UWCubeSat/HS1_Motor_Test/MSP430 Breakout_V2/MSP430 Breakout.kicad_pcb

## KiCad design MSP430 Breakout_V2/MSP430 Breakout.kicad_pcb (2022-03-03)

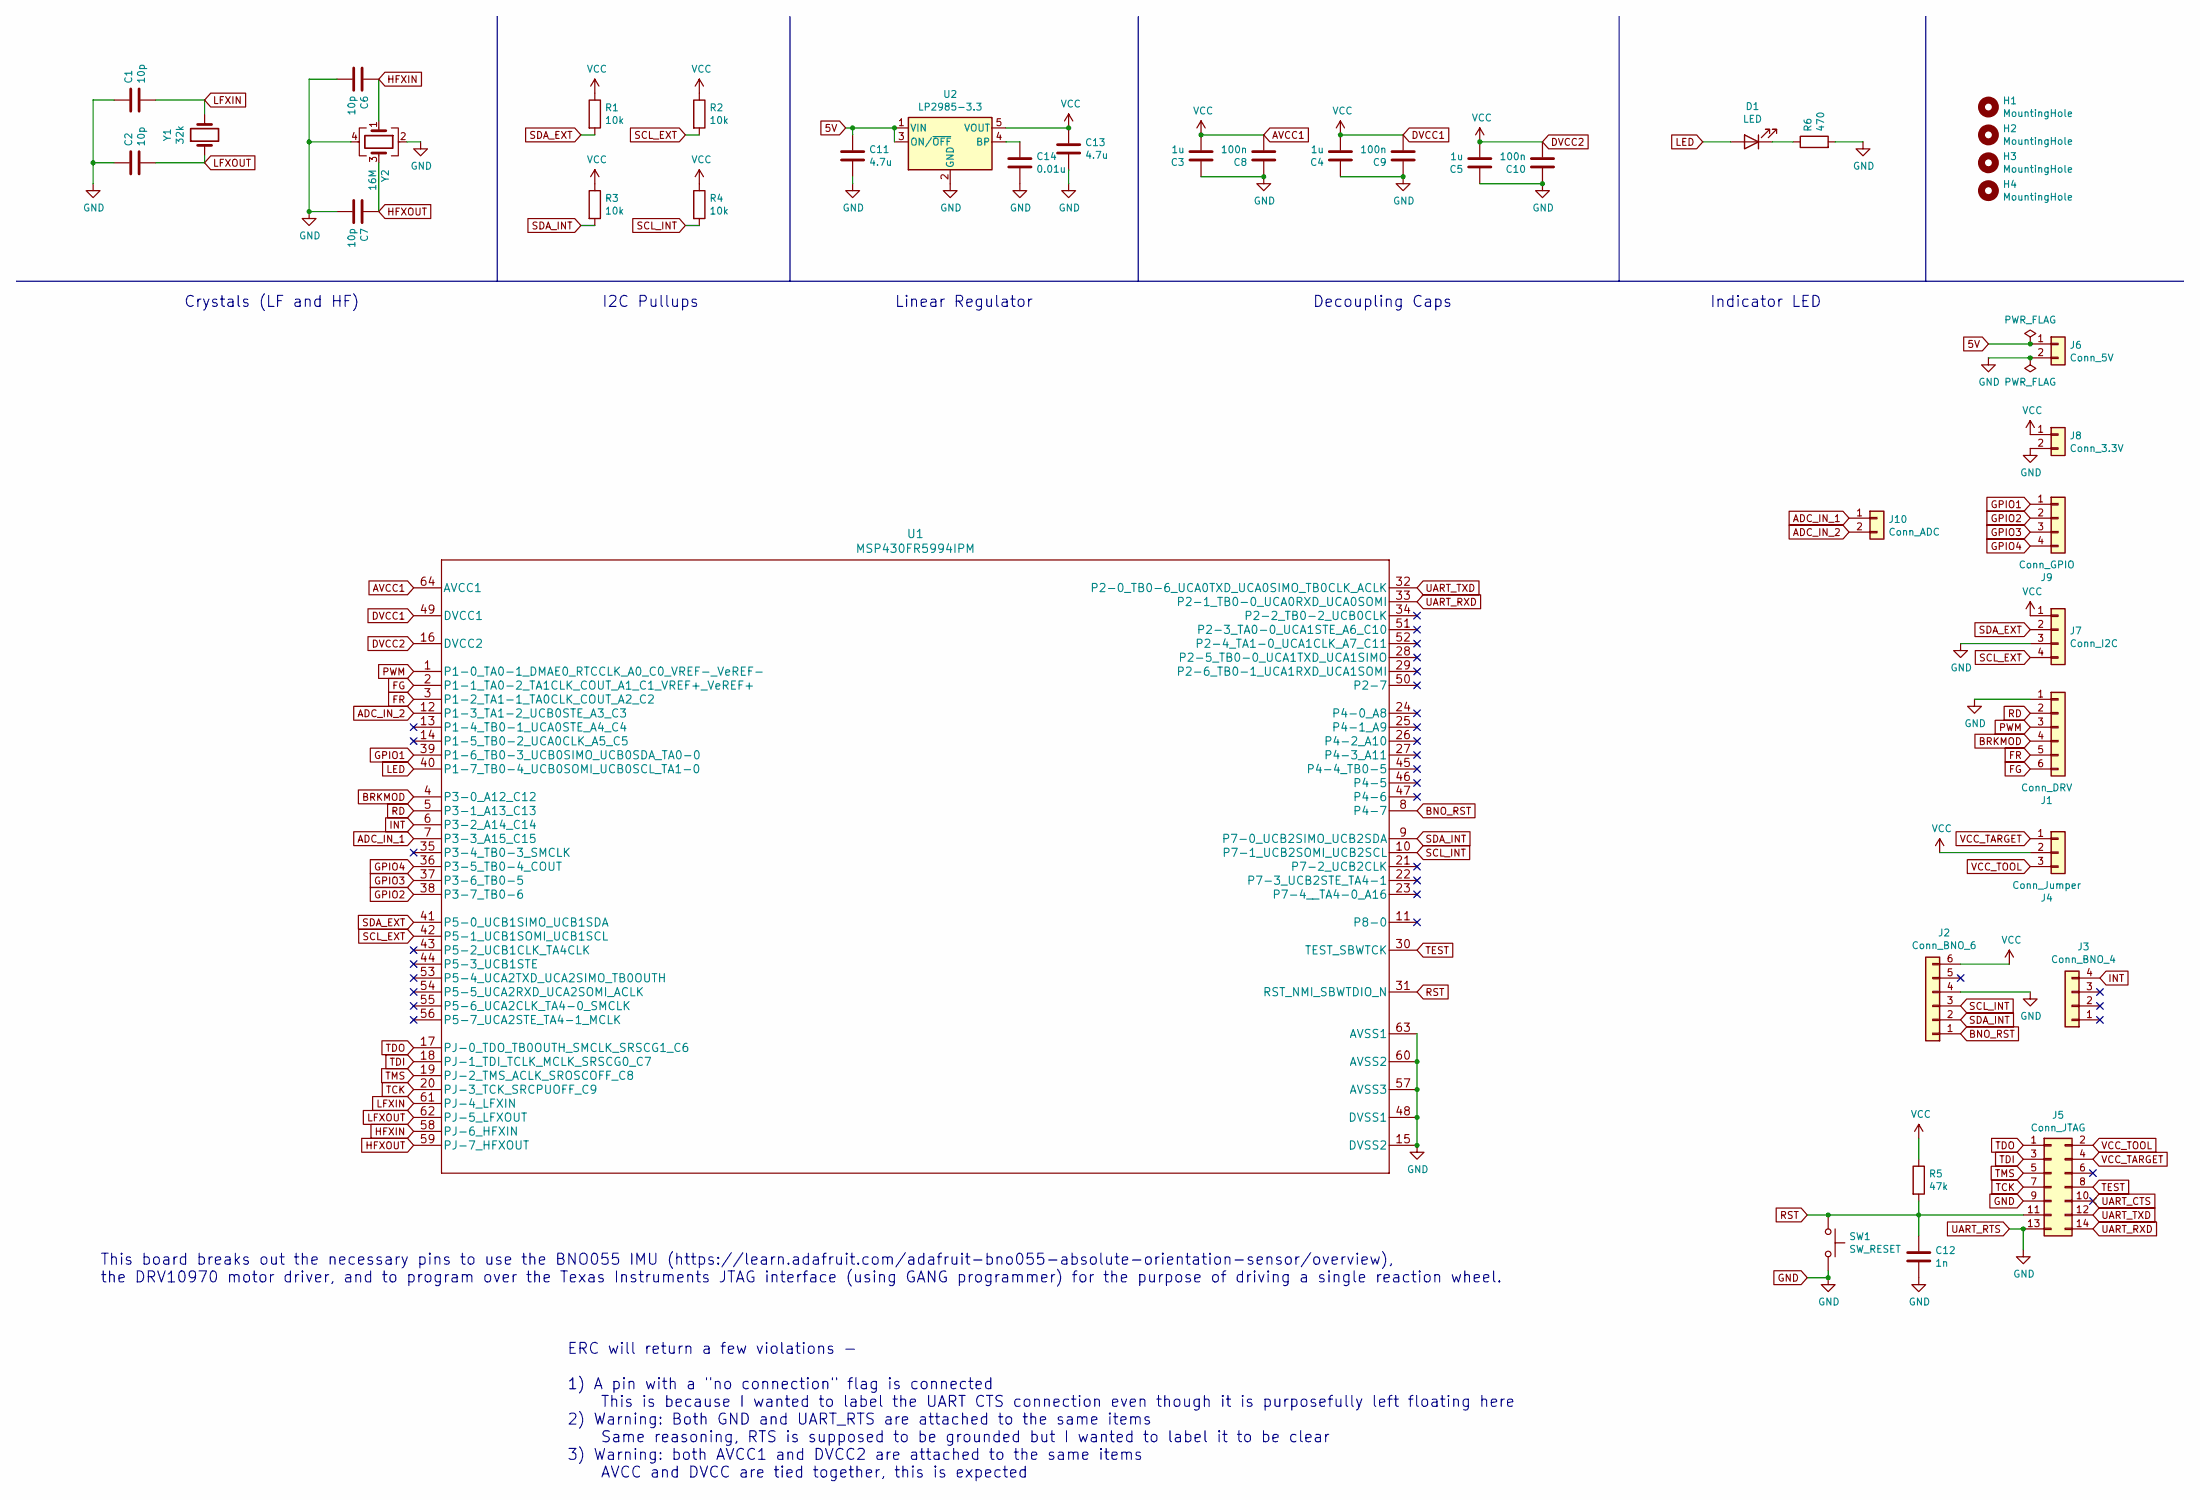
[picture p1: schematic MSP430 Breakout.kicad_sch, MSP430 Reaction Wheels Breakout V2]

Parts:
C1, C2, C6, C7: 10p; C_0805_2012Metric_Pad1.18x1.45mm_HandSolder
C3, C4, C5: 1u; C_0805_2012Metric_Pad1.18x1.45mm_HandSolder
C8, C9, C10: 100n; C_0805_2012Metric_Pad1.18x1.45mm_HandSolder
C11, C13: 4.7u; C_0805_2012Metric_Pad1.18x1.45mm_HandSolder
C12: 1n; C_0805_2012Metric_Pad1.18x1.45mm_HandSolder
C14: 0.01u; C_0805_2012Metric_Pad1.18x1.45mm_HandSolder
D1: LED; LED_0805_2012Metric_Pad1.15x1.40mm_HandSolder
H1, H2, H3, H4: MountingHole; MountingHole_2.5mm_Pad_Via
J1: Conn_DRV; PinSocket_1x06_P2.54mm_Vertical
J2: Conn_BNO_6; PinSocket_1x06_P2.54mm_Vertical
J3: Conn_BNO_4; PinSocket_1x04_P2.54mm_Vertical
J4: Conn_Jumper; PinHeader_1x03_P2.54mm_Vertical
J5: Conn_JTAG; PinHeader_2x07_P2.54mm_Vertical
J6: Conn_5V; PinSocket_1x02_P2.54mm_Vertical
J7: Conn_I2C; PinSocket_1x04_P2.54mm_Vertical
J8: Conn_3.3V; PinSocket_1x02_P2.54mm_Vertical
J9: Conn_GPIO; PinSocket_1x04_P2.54mm_Vertical
J10: Conn_ADC; PinSocket_1x02_P2.54mm_Vertical
R1, R2, R3, R4: 10k; R_0805_2012Metric_Pad1.20x1.40mm_HandSolder
R5: 47k; R_0805_2012Metric_Pad1.20x1.40mm_HandSolder
R6: 470; R_0805_2012Metric_Pad1.20x1.40mm_HandSolder
SW1: SW_RESET; SW_PUSH_6mm_H5mm
U1: MSP430FR5994IPM
U2: LP2985-3.3; SOT-23-5
Y1: 32k; Crystal_SMD_2012-2Pin_2.0x1.2mm
Y2: 16M; Crystal_SMD_3225-4Pin_3.2x2.5mm_HandSoldering

Connections:
5V: C11.1, J6.1, U2.1 (VIN), U2.3 (ON/~OFF)
ADC_IN_1: J10.1, U1.7 (P3-3_A15_C15)
ADC_IN_2: J10.2, U1.12 (P1-3_TA1-2_UCB0STE_A3_C3)
AVCC1: C3.2, C4.2, C5.2, C8.2, C9.2, C10.2, C13.1, J2.6, J4.2, J7.1, J8.1, R1.1, R2.1, R3.1, R4.1, R5.1, U1.16 (DVCC2), U1.49 (DVCC1), U1.64 (AVCC1), U2.5 (VOUT)
BNO_RST: J2.1, U1.8 (P4-7)
BRKMOD: J1.4, U1.4 (P3-0_A12_C12)
FG: J1.6, U1.2 (P1-1_TA0-2_TA1CLK_COUT_A1_C1_VREF+_VeRE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)
FR: J1.5, U1.3 (P1-2_TA1-1_TA0CLK_COUT_A2_C2)
GND: C1.1, C2.1, C3.1, C4.1, C5.1, C6.2, C7.2, C8.1, C9.1, C10.1, C11.2, C12.2, C13.2, C14.2, J1.1, J2.4, J5.9, J5.13, J6.2, J7.3, J8.2, R6.2, SW1.2, U1.15 (DVSS2), U1.48 (DVSS1), U1.57 (AVSS3), U1.60 (AVSS2), U1.63 (AVSS1), U2.2 (GND), Y2.2, Y2.4
GPIO1: J9.1, U1.39 (P1-6_TB0-3_UCB0SIMO_UCB0SDA_TA0-0)
GPIO2: J9.2, U1.38 (P3-7_TB0-6)
GPIO3: J9.3, U1.37 (P3-6_TB0-5)
GPIO4: J9.4, U1.36 (P3-5_TB0-4_COUT)
HFXIN: C6.1, U1.58 (PJ-6_HFXIN), Y2.1
HFXOUT: C7.1, U1.59 (PJ-7_HFXOUT), Y2.3
INT: J3.4, U1.6 (P3-2_A14_C14)
LED: D1.2 (A), U1.40 (P1-7_TB0-4_UCB0SOMI_UCB0SCL_TA1-0)
LFXIN: C1.2, U1.61 (PJ-4_LFXIN), Y1.2
LFXOUT: C2.2, U1.62 (PJ-5_LFXOUT), Y1.1
unnamed: C14.1, U2.4 (BP)
unnamed: D1.1 (K), R6.1
PWM: J1.3, U1.1 (P1-0_TA0-1_DMAE0_RTCCLK_A0_C0_VREF-_VeR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)
RD: J1.2, U1.5 (P3-1_A13_C13)
RST: C12.1, J5.11, R5.2, SW1.1, U1.31 (RST_NMI_SBWTDIO_N)
SCL_EXT: J7.4, R2.2, U1.42 (P5-1_UCB1SOMI_UCB1SCL)
SCL_INT: J2.3, R4.2, U1.10 (P7-1_UCB2SOMI_UCB2SCL)
SDA_EXT: J7.2, R1.2, U1.41 (P5-0_UCB1SIMO_UCB1SDA)
SDA_INT: J2.2, R3.2, U1.9 (P7-0_UCB2SIMO_UCB2SDA)
TCK: J5.7, U1.20 (PJ-3_TCK_SRCPUOFF_C9)
TDI: J5.3, U1.18 (PJ-1_TDI_TCLK_MCLK_SRSCG0_C7)
TDO: J5.1, U1.17 (PJ-0_TDO_TB0OUTH_SMCLK_SRSCG1_C6)
TEST: J5.8, U1.30 (TEST_SBWTCK)
TMS: J5.5, U1.19 (PJ-2_TMS_ACLK_SROSCOFF_C8)
UART_CTS: J5.10
UART_RXD: J5.14, U1.33 (P2-1_TB0-0_UCA0RXD_UCA0SOMI)
UART_TXD: J5.12, U1.32 (P2-0_TB0-6_UCA0TXD_UCA0SIMO_TB0CLK_ACLK)
VCC_TARGET: J4.1, J5.4
VCC_TOOL: J4.3, J5.2

Notes on the sheet:
I2C Pullups
This board breaks out the necessary pins to use the BNO055 IMU (https://learn.adafruit.com/adafruit-bno055-absolute-orientation-sensor/overview), the DRV10970 motor driver, and to program over the Texas Instruments JTAG interface (using GANG programmer) for the purpose of driving a single reaction 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
ERC will return a few violations - 1) A pin with a "no connection" flag is connected This is because I wanted to label the UART CTS connection even though it is purposefully left floating here 2) Warning: Both GND and UART_RTS are attached to the same items Same reasoning, RTS is supposed to be gro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
Linear Regulator
Decoupling Caps
Crystals (LF and HF)
Indicator LED

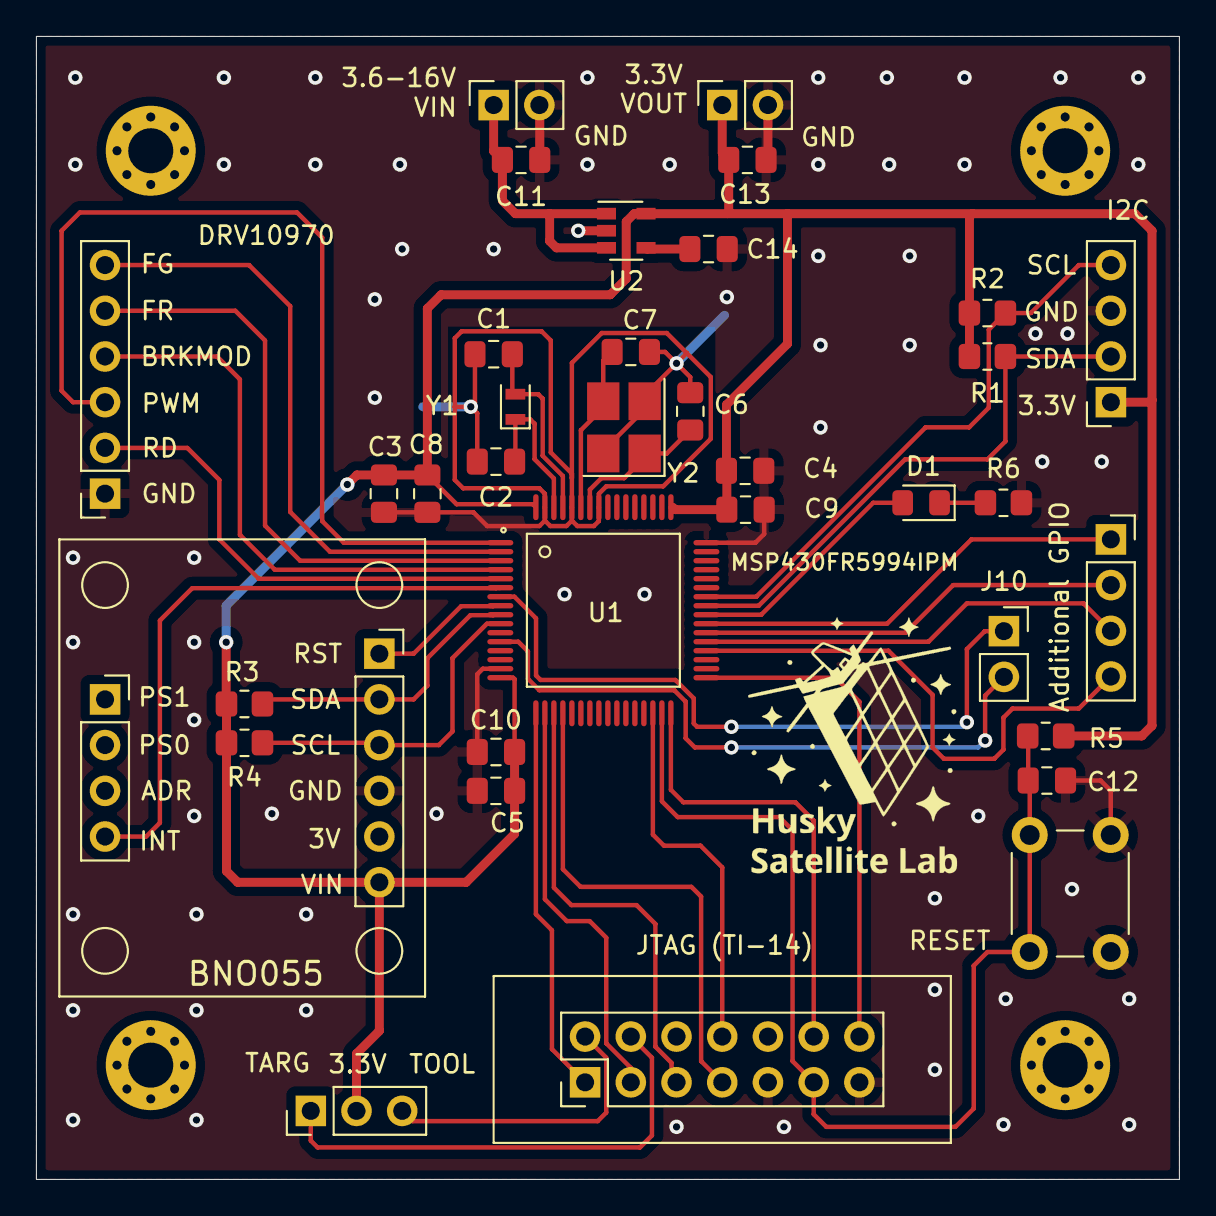
[picture p2: board MSP430 Breakout.kicad_pcb from above]

Board: 2 copper layers, 63.5 x 63.5 mm, 40 parts (0 on the bottom side), 37 nets.
