UWCubeSat/HS1_Motor_Test/Modular_single_driver_Driver/Modular_single_driver_Driver.kicad_pcb

## KiCad design Modular_single_driver_Driver/Modular_single_driver_Driver.kicad_pcb (2021-11-17)

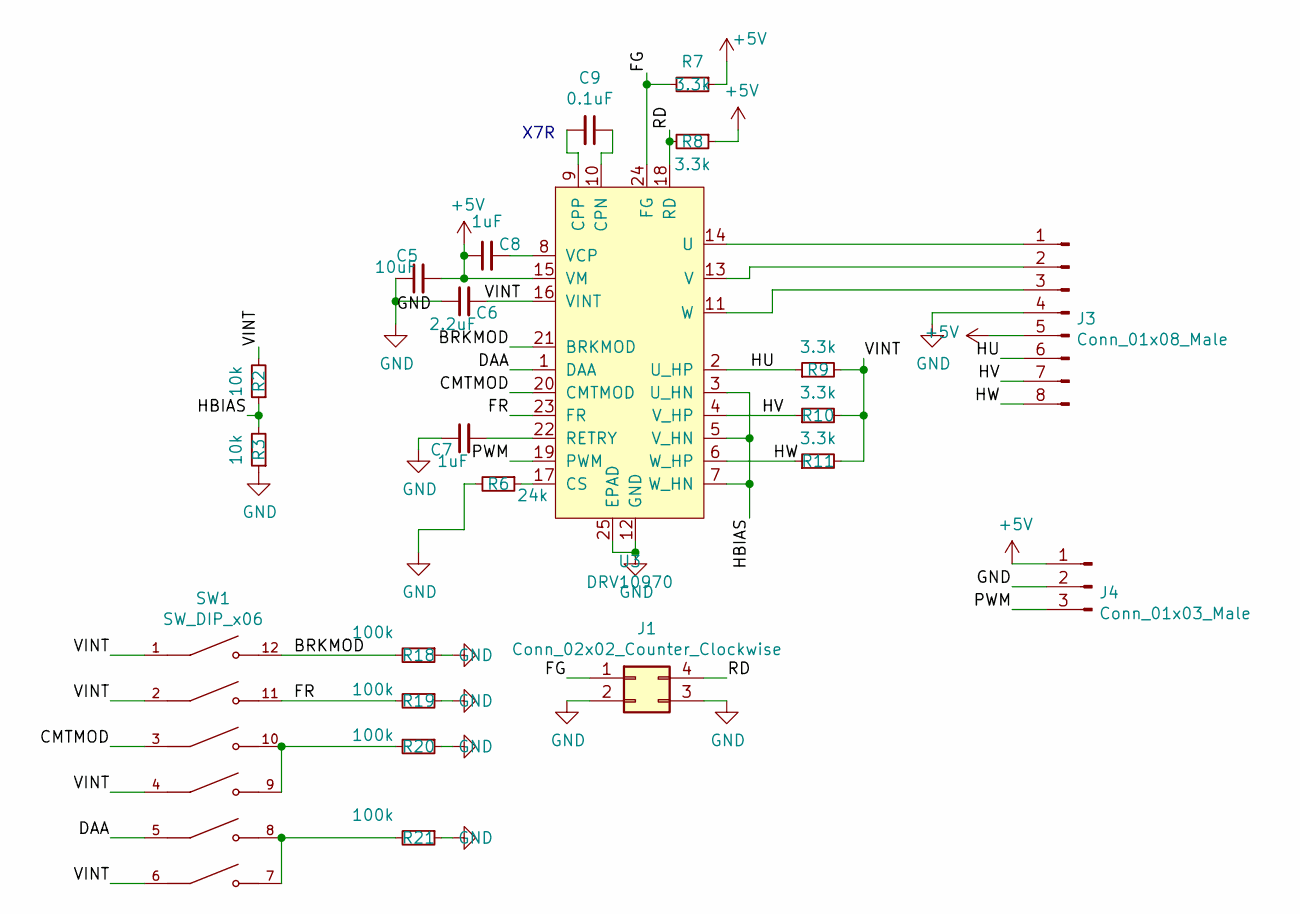
[picture p3: schematic Modular_single_driver_Driver.sch]

Parts:
C5: 10uF; C_0603_1608Metric
C6: 2.2uF; C_0603_1608Metric
C7, C8: 1uF; C_0603_1608Metric
C9: 0.1uF; C_0603_1608Metric
J1: Conn_02x02_Counter_Clockwise; PinHeader_2x02_P2.54mm_Vertical
J3: Conn_01x08_Male; PinHeader_1x08_P2.54mm_Vertical
J4: Conn_01x03_Male; PinHeader_1x03_P2.54mm_Vertical
R2, R3: 10k; R_0603_1608Metric
R6: 24k; R_0603_1608Metric
R7, R8, R9, R10, R11: 3.3k; R_0603_1608Metric
R18, R19, R20, R21: 100k; R_0603_1608Metric
SW1: SW_DIP_x06; DIP762W56P254L1772H585Q12
U3: DRV10970; HTSSOP-24-1EP_4.4x7.8mm_P0.65mm_EP3.4x7.8mm_Mask2.4x4.68mm_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

Connections:
+5V: C5.2, C8.1, J3.5, J4.1, R7.1, R8.1, U3.15 (VM); also elsewhere on the board
/BRKMOD: R18.2, SW1.12, U3.21 (BRKMOD)
/CMTMOD: SW1.3, U3.20 (CMTMOD)
/DAA: SW1.5, U3.1 (DAA)
/FG: J1.1, R7.2, U3.24 (FG)
/FR: R19.2, SW1.11, U3.23 (FR)
/HBIAS: R2.1, R3.2, U3.3 (U_HN), U3.5 (V_HN), U3.7 (W_HN)
/HU: J3.6, R9.1, U3.2 (U_HP)
/HV: J3.7, R10.1, U3.4 (V_HP)
/HW: J3.8, R11.1, U3.6 (W_HP)
/PWM: J4.3, U3.19 (PWM); also elsewhere on the board
/RD: J1.4, R8.2, U3.18 (RD)
/VINT: C6.2, R2.2, R9.2, R10.2, R11.2, SW1.1, SW1.2, SW1.4, SW1.6, U3.16 (VINT)
GND: C5.1, C6.1, C7.1, J1.2, J1.3, J3.4, J4.2, R3.1, R6.2, R18.1, R19.1, R20.1, R21.1, U3.12 (GND), U3.25 (EPAD); also elsewhere on the board
unnamed: C7.2, U3.22 (RETRY)
unnamed: C8.2, U3.8 (VCP)
unnamed: C9.1, U3.10 (CPN)
unnamed: C9.2, U3.9 (CPP)
unnamed: J3.1, U3.14 (U)
unnamed: J3.2, U3.13 (V)
unnamed: J3.3, U3.11 (W)
unnamed: R6.1, U3.17 (CS)
unnamed: R20.2, SW1.9, SW1.10
unnamed: R21.2, SW1.7, SW1.8

Notes on the sheet:
X7R

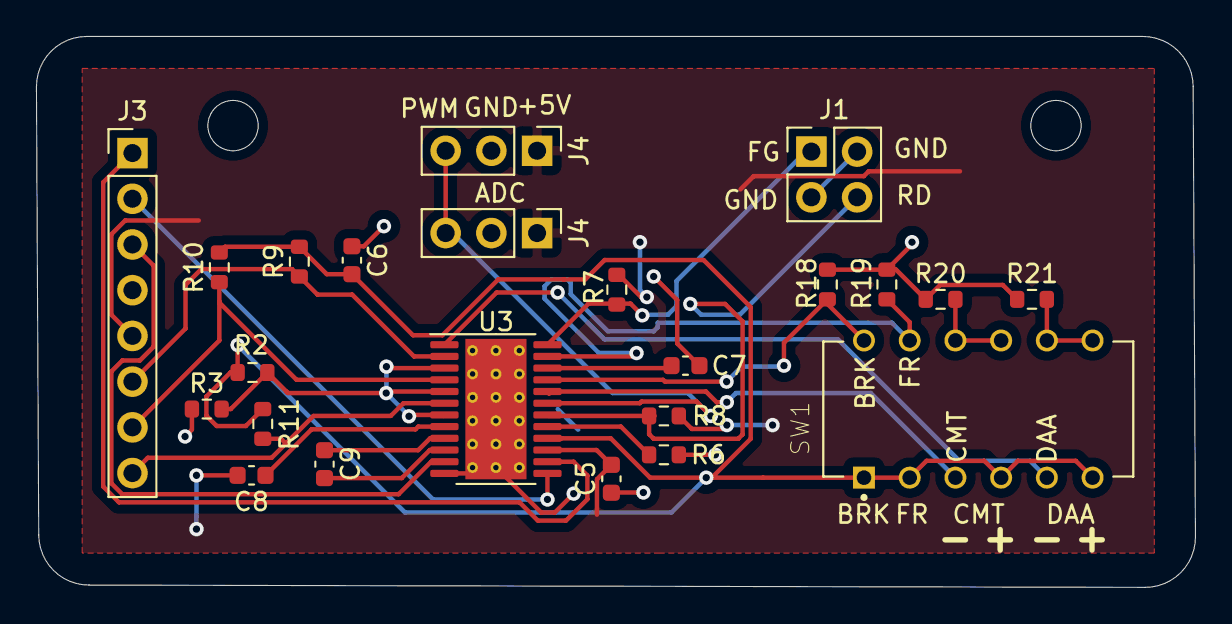
[picture p4: board Modular_single_driver_Driver.kicad_pcb from above]

Board: 2 copper layers, 64.4 x 30.6 mm, 23 parts (0 on the bottom side), 24 nets.

Other parts of the board:
J4#2: Conn_01x03_Male; PinHeader_1x03_P2.54mm_Vertical

Their connections:
+5V: J4#2.1; also elsewhere on the board
/PWM: J4#2.3; also elsewhere on the board
GND: J4#2.2; also elsewhere on the board
