UWCubeSat/HS1_Motor_Test/Modular_pwm_dac_LTC6992/Modular_pwm_dac_LTC6992.kicad_pcb

## KiCad design Modular_pwm_dac_LTC6992/Modular_pwm_dac_LTC6992.kicad_pcb (2021-04-08)

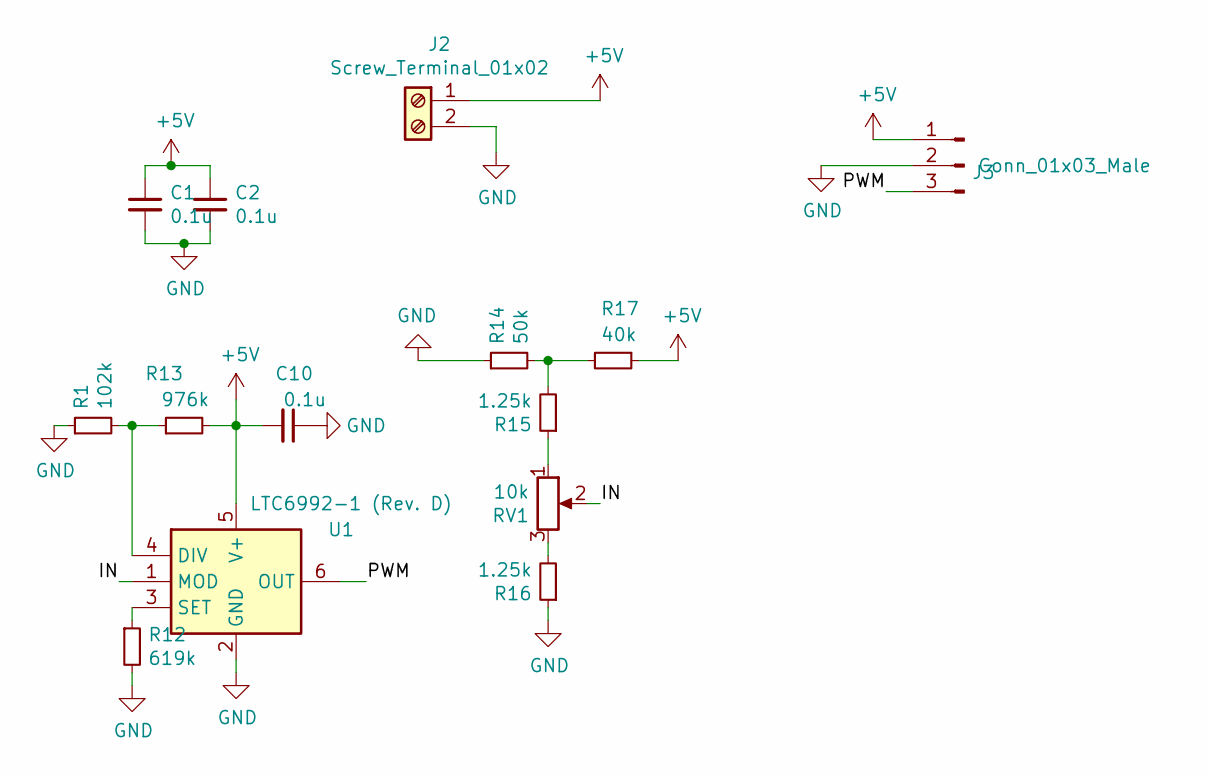
[picture p5: schematic Modular_pwm_dac_LTC6992.sch]

Parts:
C1, C2, C10: 0.1u; C_0603_1608Metric
J2: Screw_Terminal_01x02; TerminalBlock_Phoenix_PT-1,5-2-3.5-H_1x02_P3.50mm_Horizontal
J3: Conn_01x03_Male; PinHeader_1x03_P2.54mm_Vertical
R1: 102k; R_0603_1608Metric
R12: 619k; R_0603_1608Metric
R13: 976k; R_0603_1608Metric
R14: 50k; R_0603_1608Metric
R15, R16: 1.25k; R_0603_1608Metric
R17: 40k; R_0603_1608Metric
RV1: 10k; PinHeader_1x03_P2.54mm_Vertical
U1: LTC6992-1 (Rev. D); SOT-23-6_Handsoldering

Connections:
+5V: C1.1, C2.1, C10.2, J2.1, J3.1, R13.2, R17.1, U1.5 (V+); also elsewhere on the board
/IN: RV1.2, U1.1 (MOD)
/PWM: J3.3, U1.6 (OUT); also elsewhere on the board
GND: C1.2, C2.2, C10.1, J2.2, J3.2, R1.1, R12.2, R14.1, R16.1, U1.2 (GND); also elsewhere on the board
unnamed: R1.2, R13.1, U1.4 (DIV)
unnamed: R12.1, U1.3 (SET)
unnamed: R14.2, R15.2, R17.2
unnamed: R15.1, RV1.1
unnamed: R16.2, RV1.3

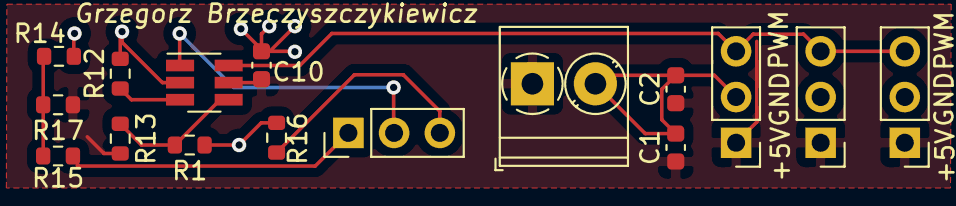
[picture p6: board Modular_pwm_dac_LTC6992.kicad_pcb from above]

Board: 2 copper layers, 16 parts (0 on the bottom side), 9 nets.

Other parts of the board:
J3#2, J3#3: Conn_01x03_Male; PinHeader_1x03_P2.54mm_Vertical

Their connections:
+5V: J3#2.1, J3#3.1; also elsewhere on the board
/PWM: J3#2.3, J3#3.3; also elsewhere on the board
GND: J3#2.2, J3#3.2; also elsewhere on the board
