UWCubeSat/HS1_Motor_Test/Modular_single_driver_Regulator/Modular_single_driver_Regulator.kicad_pcb

## KiCad design Modular_single_driver_Regulator/Modular_single_driver_Regulator.kicad_pcb (2021-02-01)

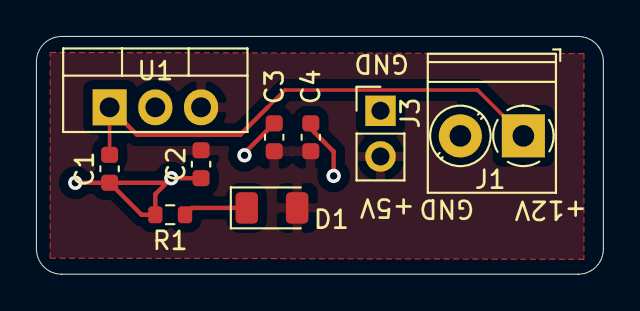
[picture p7: board Modular_single_driver_Regulator.kicad_pcb from above]

Board: 2 copper layers, 31.5 x 13.2 mm, 9 parts (0 on the bottom side), 4 nets.

Parts:
C1: 0.33u; C_0603_1608Metric
C2, C3, C4: 0.1u; C_0603_1608Metric
D1: LED; LED_1206_3216Metric
J1: Screw_Terminal_01x02; TerminalBlock_Phoenix_PT-1,5-2-3.5-H_1x02_P3.50mm_Horizontal
J3: Conn_01x02_Male; PinHeader_1x02_P2.54mm_Vertical
R1: 510; R_0603_1608Metric
U1: LM7805_TO220; TO-220-3_Vertical

Connections:
+5V: C2.1, C3.1, C4.1, D1.2, J3.2, U1.3
+12V: C1.1, J1.1, U1.1
GND: C1.2, C2.2, C3.2, C4.2, J1.2, J3.1, R1.2, U1.2
unnamed: D1.1, R1.1
