UWCubeSat/HS1_Motor_Test/(commit log)

2020-11-28 Added design files
    [single_driver-B_Cu.gbr, single_driver-B_Mask.gbr, single_driver-B_Paste.gbr, single_driver-B_SilkS.gbr, single_driver-Edge_Cuts.gbr, single_driver-F_Cu.gbr, single_driver-F_Mask.gbr, single_driver-F_Paste.gbr]
2020-12-04 Started circuit for 555 timer duty cycle
    PWM Duty Cycle signal generator for reaction wheel testing
    [single_driver_555timer.sch]
2020-12-06 New RW driver PCB
    Instead of AVR, using analog to PWM duty cycle converter IC
2020-12-06 slight adjustments to new rw pcb
    [single_driver LTC6992.sch]
2020-12-06 Added header for lock and tach
    [single_driver LTC6992.sch]
2020-12-15 Added DIP switch
    DIP switch will control various aspects of the control algorithm
    [single_driver LTC6992.sch]
2020-12-15 Slight changes
    [single_driver LTC6992.sch]
2020-12-15 Started PCB
    [single_driver LTC6992.kicad_pcb, single_driver LTC6992.sch]
2020-12-21 Changed current sensing resistor
    [single_driver LTC6992.sch]
2020-12-21 More PCB work
2021-01-06 Basically finished pcb
    [single_driver LTC6992.kicad_pcb, single_driver LTC6992.sch]
2021-01-11 Starting Rev. 2
    [single_driver LTC6992(Rev1).kicad_pcb]
2021-01-12 Created Rev.2 for test
    [single_driver LTC6992.kicad_pcb]
2021-01-13 Created new project for PWM test
    [pwm_dac_LTC6992.kicad_pcb, pwm_dac_LTC6992.sch]
2021-01-13 More PWM dac stuffff
    [pwm_dac_LTC6992.sch]
2021-01-14 Mostly finished PCB for ADC
    [pwm_dac_LTC6992.sch]
2021-01-14 Finished PCB with header output/support
    [pwm_dac_LTC6992.kicad_pcb]
2021-01-14 Built PCB
    [pwm_dac_LTC6992.kicad_pcb]
2021-01-19 Organized and renamed files
    [Modular_pwm_dac_LTC6992.kicad_pcb, Modular_pwm_dac_LTC6992.sch, Modular_single_driver_Driver.kicad_pcb, Modular_single_driver_Driver.sch, Modular_single_driver_Regulator.sch, single_driver LTC6992(Rev1).kicad_pcb, single_driver LTC6992.kicad_pcb]
2021-01-26 Finished All
    [Modular_pwm_dac_LTC6992.kicad_pcb]
2021-01-27 some stuyff
    [Modular_single_driver_Regulator.kicad_pcb]
2021-02-01 I guess i did some stuff
    [single_driver LTC6992(Rev1).kicad_pcb, single_driver LTC6992.kicad_pcb, single_driver LTC6992.sch]
2021-02-01 Yes they are
    [Modular_pwm_dac_LTC6992-B_Cu.gbr, Modular_pwm_dac_LTC6992-B_Mask.gbr, Modular_pwm_dac_LTC6992-B_Paste.gbr, Modular_pwm_dac_LTC6992-B_SilkS.gbr, Modular_pwm_dac_LTC6992-Edge_Cuts.gbr, Modular_pwm_dac_LTC6992-F_Cu.gbr, Modular_pwm_dac_LTC6992-F_Mask.gbr, Modular_pwm_dac_LTC6992-F_Paste.gbr]
2021-02-15 Basically finished MSP430 Single
    [Modular_MSP430.kicad_pcb, Modular_MSP430.sch]
2021-04-08 NEW PCB
    Changed some names of old PCBs, and created new PCB with the new package
    [Modular_pwm_dac_LTC6992.kicad_pcb, Modular_pwm_dac_LTC6992.sch, Modular_pwm_dac_LTC6992_REV1.kicad_pcb]
2021-04-14 Built a matlab script, terrible scripts
    Built scripts for 555 timer for turning a potentiometer (i.e. knob) to adjust pwm signal dooty cycle
2021-07-25 MSP430 Breakout Board
    Board for interfacing BNO055 IMU and DRV10970 motor driver with MSP430FR5994IPM
    [MSP430 Breakout-B_Cu.gbl, MSP430 Breakout-B_Mask.gbs, MSP430 Breakout-B_Paste.gbp, MSP430 Breakout-B_SilkS.gbo, MSP430 Breakout-Edge_Cuts.gm1, MSP430 Breakout-F_Cu.gtl, MSP430 Breakout-F_Mask.gts, MSP430 Breakout-F_Paste.gtp]
2021-11-17 Updated connections and component values
    - Updated component values to reflect those shown in the datasheet
    - Connected HBIAS pins to each other
    - Connected PowerPAD to ground plane
    - Cleaned up traces
    - Added some silkscreen labels to facilitate testing
    [Modular_single_driver_Driver.kicad_pcb, Modular_single_driver_Driver.sch]
2022-03-03 Add V2 MSP430 board design
    V2 fixes:
    Hand solder footprint for high frequency crystal
    BSL UART pins fixed (tx and rx were backward on V1)
    Added pins to access ADC inputs, for using a potentiometer to control motor speed.
    [MSP430 Breakout-B_Cu.gbr, MSP430 Breakout-B_Mask.gbr, MSP430 Breakout-B_Silkscreen.gbr, MSP430 Breakout-Edge_Cuts.gbr, MSP430 Breakout-F_Cu.gbr, MSP430 Breakout-F_Mask.gbr, MSP430 Breakout-F_Silkscreen.gbr, MSP430 Breakout-NPTH.drl]
